StudioKAT/AnalogChaos/README.md

# Analog Chaos

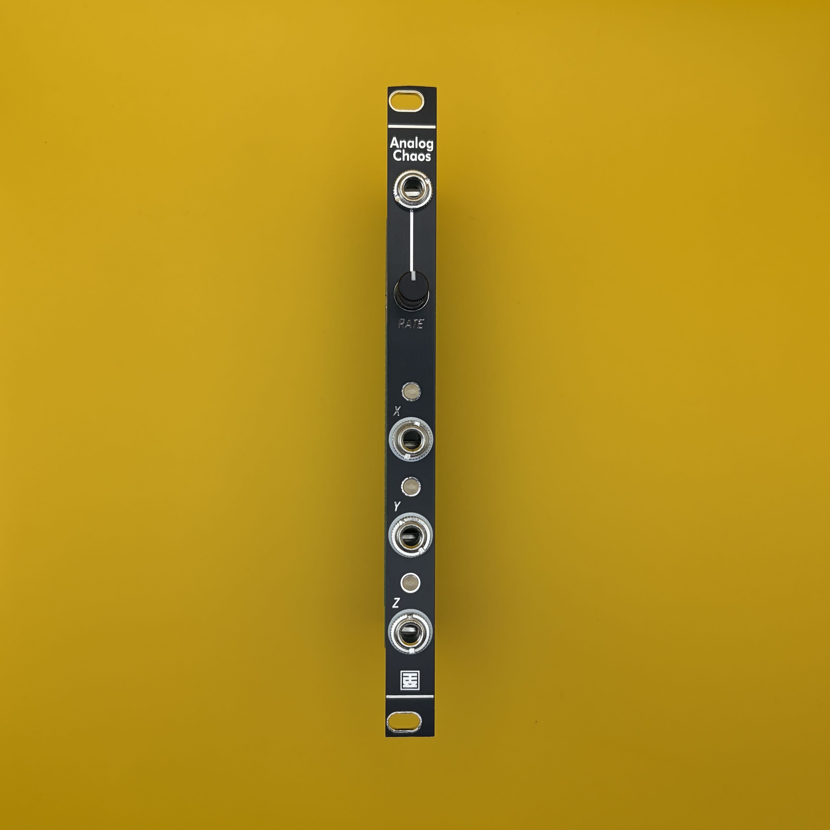
[picture p1: v2.0/Images/Analog Chaos_v2.0_Front.jpg]
Analog Chaos_v2.0_Front


## 概要 / Overview

**Analog Chaos**は、2HPサイズの電圧制御可能なJerk Chaos CVジェネレーターです。

アナログ回路のフィードバックが生み出す、決定論的でありながら不規則な変化が特徴です。パッチに「偶然のようで、どこか連続性のある」揺らぎを加えます。

相互に関連しながら異なる表情を見せるX・Y・Zの3つのCV出力を搭載。複数のパラメーターを同時に変調することで、つながりのある複雑な動きを作り出せます。

変化の速度はRateノブと外部CVで調整でき、超低速域からLFO領域まで対応します。ゆっくりと移り変わる音色から、不規則なうねりまで、幅広いモジュレーションに活用できます。

基板上には、動きの性質を調整する4つの半固定抵抗を備えています。  
- Damp：振動を抑える帰還の強さを調整します。動きの勢いや収まり方に関わります。
- Gain：信号を回路へ戻す帰還の利得を調整します。出力音量ではなく、カオスを生み出すループの働きに関わります。
- Mod：回路内部に加える直流バイアスを調整します。動作の中心をずらすことで、揺らぎの偏りや動き方を変化させます。
- NL Drive：ダイオードによる非線形帰還の強さを調整します。波形の折れ曲がり方や、不規則な動きの生じ方に関わります。

これらは互いに影響し合い、設定によって不規則な揺らぎから周期的な動き、変化が収まる状態まで、振る舞いが変化します。

---

**Analog Chaos** is a voltage-controlled jerk chaos CV generator in a compact 2HP Eurorack format.

Feedback within its analog circuitry produces behavior that is deterministic yet irregular, adding fluctuations to your patch that feel unpredictable while retaining a sense of continuity.

Three CV outputs—X, Y, and Z—provide distinct but interrelated signals. Modulate multiple parameters simultaneously to create complex, connected movement throughout your patch.

The Rate knob and external CV input control the speed of these changes, covering a range from ultra-slow movement to LFO rates. From gradually evolving timbres to irregular swells, Analog Chaos offers a wide range of modulation possibilities.

Four trimmers on the circuit board let you adjust the character of the movement:

- **Damp:** Adjusts the strength of the feedback that damps oscillation, influencing how vigorously the circuit moves and how its motion settles.
- **Gain:** Adjusts the gain of the feedback loop that generates chaos, shaping the circuit’s behavior rather than directly setting the output level.
- **Mod:** Adjusts an internal DC bias, shifting the circuit’s operating point to change the balance and character of its fluctuations.
- **NL Drive:** Adjusts the strength of the nonlinear feedback through the diodes, influencing how the waveform bends and how irregular movement develops.

These controls interact with one another. Depending on their settings, the circuit can move between chaotic fluctuations, periodic oscillation, and a settled state.

## 仕様 / Spec
- Format: Eurorack
- Function: Chaos
- Current needs: +12V: 25mA, -12V: 25mA
- Width: 2 HP
- Depth: 36mm (including power connector)

## 販売 / Sales

StudioKATオフィシャルショップで販売しています。(日本国内限定)  
https://www.studiokat.jp/items/164466150

## ライセンス / License

この作品は [Creative Commons 表示 - 継承 4.0 国際 (CC BY-SA 4.0)](https://creativecommons.org/licenses/by-sa/4.0/deed.ja) の下でライセンスされています。  
This work is licensed under the [Creative Commons Attribution-ShareAlike 4.0 International License](https://creativecommons.org/licenses/by-sa/4.0/).

## クレジット / Credits

- Designed by : StudioKAT
- Website : https://www.studiokat.jp/
- GitHub : https://github.com/StudioKAT
- X(Twitter) : https://x.com/StudioKAT_synth
- Instagram : https://www.instagram.com/studiokat_modular/

## 更新履歴 / Changelog

- `2026-10-30` v2.0 Released version 2.0
- `2026-07-05` v1.0 Released version 1.0
