StudioKAT/AnalogChaos/v2.0/Images/Analog Chaos_v2.0_Side2.jpg

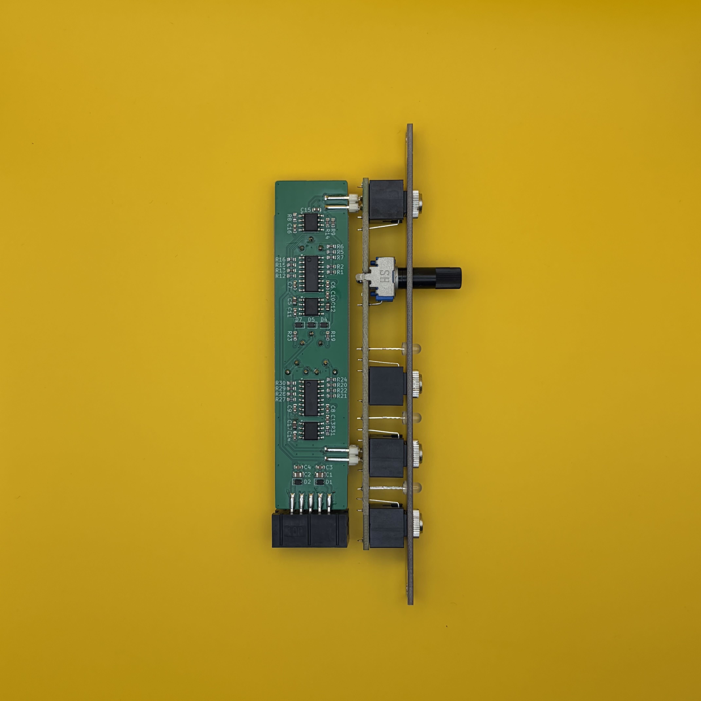
v2.0/Images/Analog Chaos_v2.0_Side2.jpg
