StudioKAT/AnalogChaos/v2.0/Gerber_for_JLCPCB/Main/bom.csv

Designator | Footprint | Quantity | Value | LCSC Part #
C1, C2 | 0805 | 2 | 22uF | C45783
C10, C11, C13, C14, C15, C16, C3, C4, C6, C7, C8, C9 | 0603 | 12 | 100nF | C14663
C12, C17, C5 | 0603 | 3 | 10uF | C96446
D1, D2 | D_SOD-323 | 2 | 1N5819WS | C191023
D3 | LED_D3.0mm_Clear | 1 | LED_Z
D4, D5, D7 | D_SOD-323 | 3 | 1N4148WS | C2128
D6 | LED_D3.0mm_Clear | 1 | LED_Y
D8 | LED_D3.0mm_Clear | 1 | LED_X
J1 | IDC-Header_2x05_P2.54mm_Horizontal_SMD_EuroPower | 1 | Power
J2 | Jack_3.5mm_QingPu_WQP-PJ398SM | 1 | Rate_CV
J3 | Jack_3.5mm_QingPu_WQP-PJ398SM | 1 | OUT_Z
J4 | Jack_3.5mm_QingPu_WQP-PJ398SM | 1 | OUT_Y
J5, J8 | PinHeader_2x02_P2.54mm_Stand_SMD | 2 | Conn_02x02_Odd_Even
J6, J9 | PinHeader_2x02_P2.54mm_Vertical_SMD | 2 | Conn_02x02_Odd_Even
J7 | Jack_3.5mm_QingPu_WQP-PJ398SM | 1 | OUT_X
R1, R13, R15, R2, R21, R22, R28, R29 | 0603 | 8 | 220 | C22962
R10, R17, R25 | 0603 | 3 | 2.2k | C4190
R11, R18, R23, R26 | 0603 | 4 | 1k | C21190
R12, R14, R19, R27, R4, R5, R8, R9 | 0603 | 8 | 100k | C25803
R16, R24, R30, R7 | 0603 | 4 | 22k | C31850
R20 | 0603 | 1 | 220k | C22961
R3 | 0603 | 1 | 120k | C25808
R31 | 0603 | 1 | 180k | C22827
R6 | 0603 | 1 | 56k | C23206
RV1 | Potentiometer_RV09 | 1 | B100K
RV2, RV3, RV5 | Potentiometer_Vishay_T73YP_Vertical | 3 | 100K
RV4 | Potentiometer_Vishay_T73YP_Vertical | 1 | 10K
U1, U4 | SOIC-16_3.9x9.9mm_P1.27mm | 2 | LM13700MX/NOPB | C174050
U2, U3, U5 | SOIC-8_3.9x4.9mm_P1.27mm | 3 | TL072CDT | C6961
