StudioKAT/AnalogChaos/v2.0/Schematics/Analog Chaos v2.0_schematics.pdf

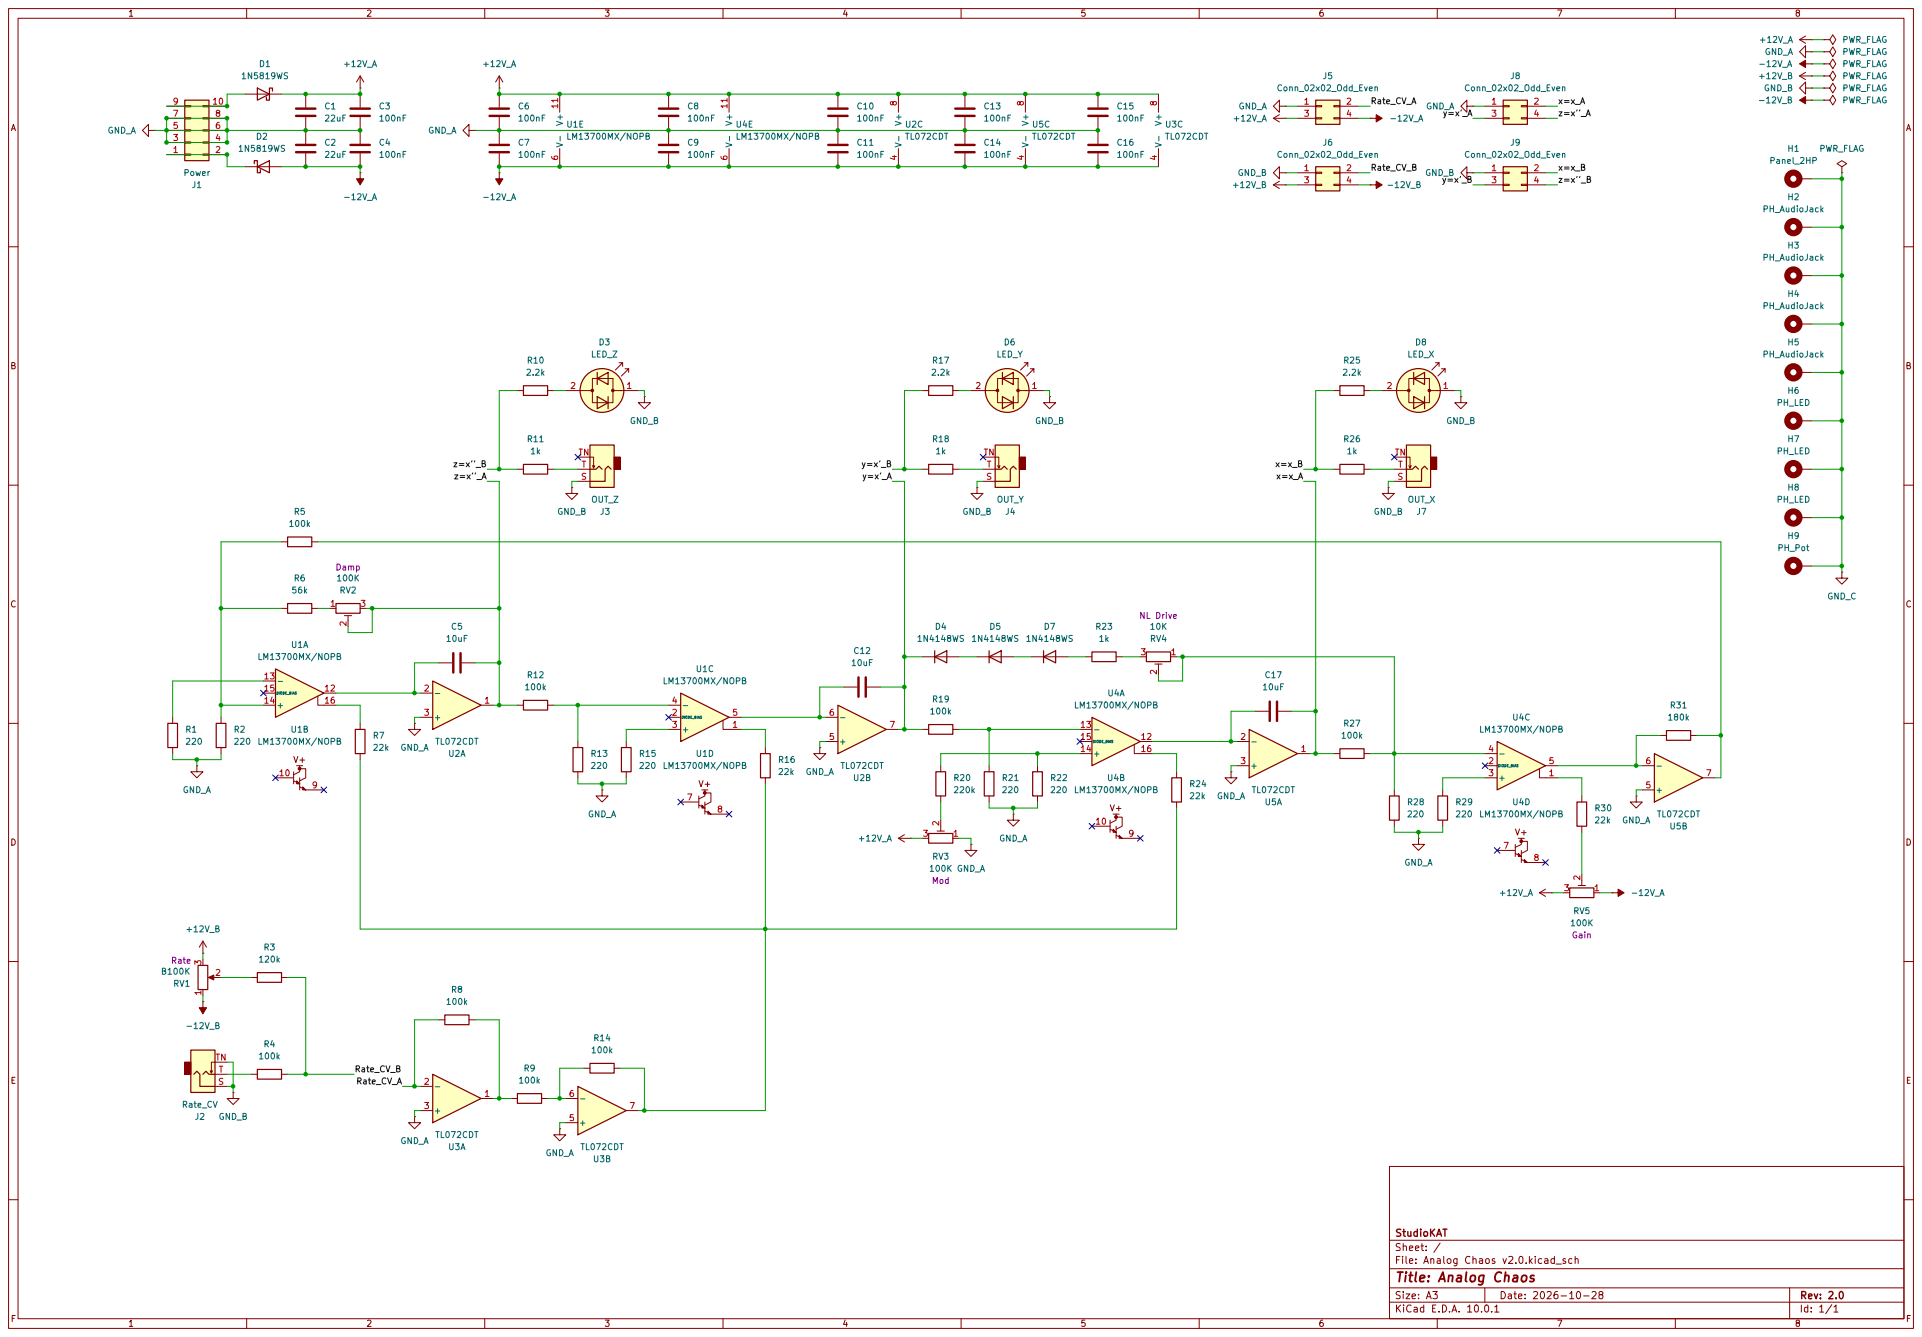
[picture p4: page 1]
