StudioKAT/AnalogChaos/v2.0/KiCAD/Analog Chaos v2.0/Analog Chaos v2.0.kicad_pcb

## KiCad design v2.0/KiCAD/Analog Chaos v2.0/Analog Chaos v2.0.kicad_pcb (2026-10-30)

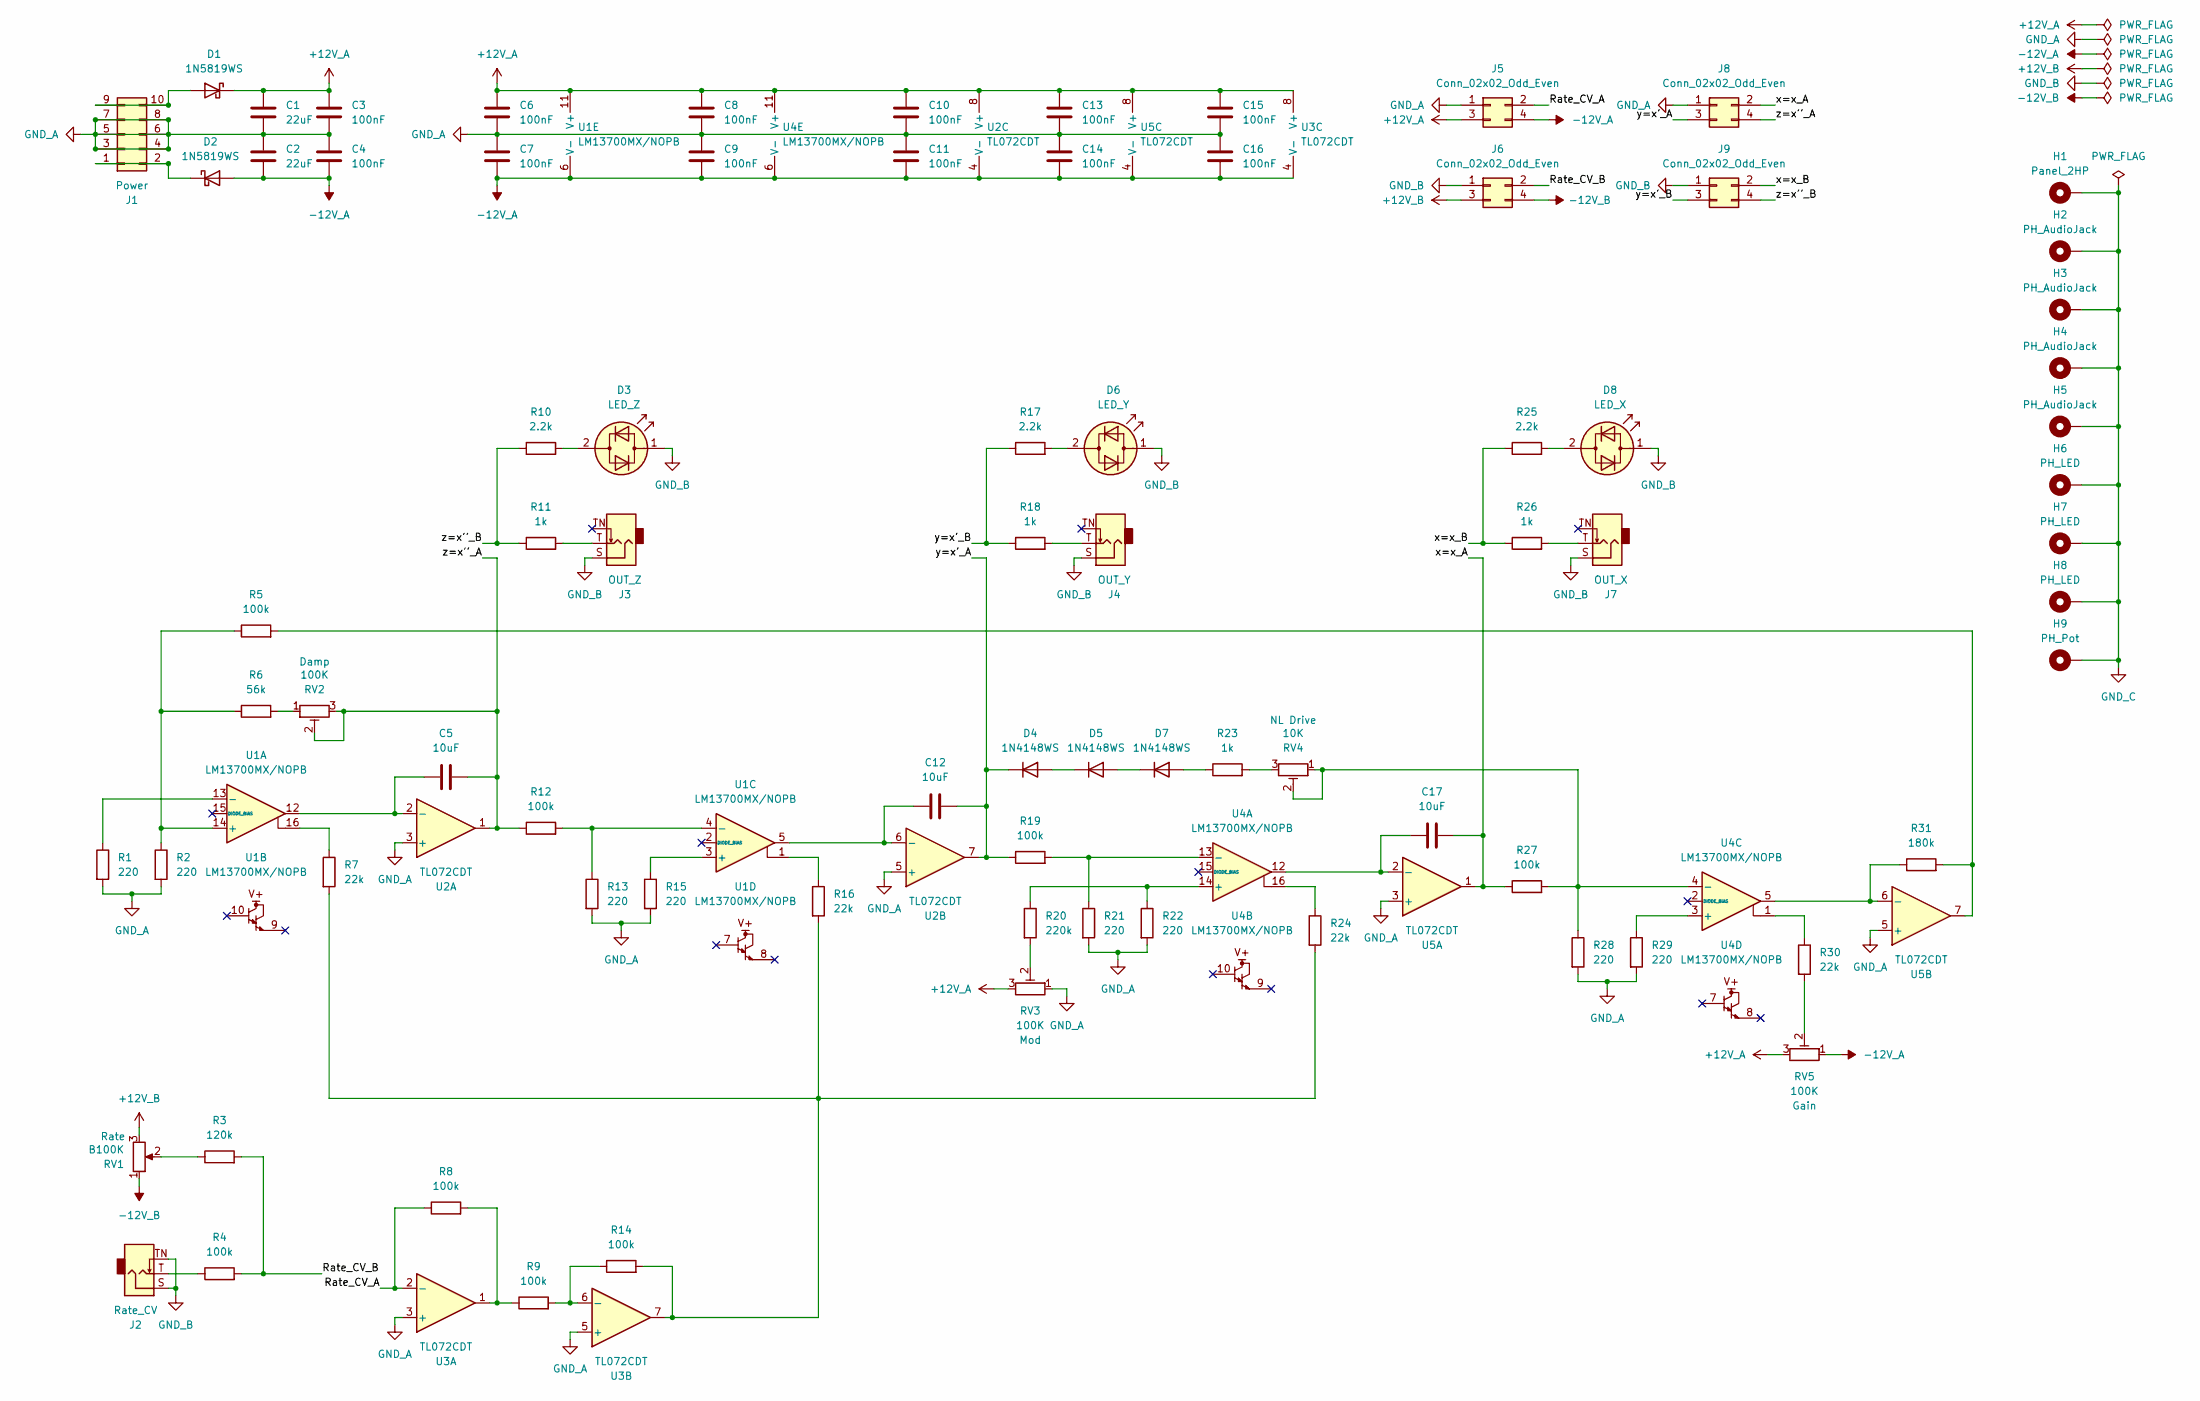
[picture p5: schematic Analog Chaos v2.0.kicad_sch, Analog Chaos]

Parts:
C1, C2: 22uF; C_0805_2012Metric; Voltage 25V; Tolerance ±20%; MFR Part CL21A226MAQNNNE; JLC Type Basic
C3, C4, C6, C7, C8, C9, C10, C11, C13, C14, C15, C16: 100nF; C_0603_1608Metric; Voltage 50V; Tolerance ±10%; MFR Part CC0603KRX7R9BB104; JLC Type Basic
C5, C12, C17: 10uF; C_0603_1608Metric; Voltage 25V; Tolerance ±20%; MFR Part CL10A106MA8NRNC; JLC Type Basic
D1, D2: 1N5819WS; D_SOD-323; MFR Part 1N5819WS; JLC Type Basic
D3: LED_Z; LED_D3.0mm_Clear
D4, D5, D7: 1N4148WS; D_SOD-323; MFR Part 1N4148WS; JLC Type Basic
D6: LED_Y; LED_D3.0mm_Clear
D8: LED_X; LED_D3.0mm_Clear
H1: Panel_2HP
H2, H3, H4, H5: PH_AudioJack; PH_AudioJack_3.5mm_Pad
H6, H7, H8: PH_LED; PH_LED_3.0mm_Pad
H9: PH_Pot; PH_RV09
J1: Power; IDC-Header_2x05_P2.54mm_Horizontal_SMD_EuroPower
J2: Rate_CV; Jack_3.5mm_QingPu_WQP-PJ398SM
J3: OUT_Z; Jack_3.5mm_QingPu_WQP-PJ398SM
J4: OUT_Y; Jack_3.5mm_QingPu_WQP-PJ398SM
J5, J8: Conn_02x02_Odd_Even; PinHeader_2x02_P2.54mm_Stand_SMD
J6, J9: Conn_02x02_Odd_Even; PinHeader_2x02_P2.54mm_Vertical_SMD
J7: OUT_X; Jack_3.5mm_QingPu_WQP-PJ398SM
R1, R2, R13, R15, R21, R22, R28, R29: 220; R_0603_1608Metric; Tolerance ±1%; MFR Part 0603WAF2200T5E; JLC Type Basic
R3: 120k; R_0603_1608Metric; Tolerance ±1%; MFR Part 0603WAF1203T5E; JLC Type Basic
R4, R5, R8, R9, R12, R14, R19, R27: 100k; R_0603_1608Metric; Tolerance ±1%; MFR Part 0603WAF1003T5E; JLC Type Basic
R6: 56k; R_0603_1608Metric; Tolerance ±1%; MFR Part 0603WAF5602T5E; JLC Type Basic
R7, R16, R24, R30: 22k; R_0603_1608Metric; Tolerance ±1%; MFR Part 0603WAF2202T5E; JLC Type Basic
R10, R17, R25: 2.2k; R_0603_1608Metric; Tolerance ±1%; MFR Part 0603WAF2201T5E; JLC Type Basic
R11, R18, R23, R26: 1k; R_0603_1608Metric; Tolerance ±1%; MFR Part 0603WAF1001T5E; JLC Type Basic
R20: 220k; R_0603_1608Metric; Tolerance ±1%; MFR Part 0603WAF2203T5E; JLC Type Basic
R31: 180k; R_0603_1608Metric; Tolerance ±1%; MFR Part 0603WAF1803T5E; LCSC C22827
RV1: B100K; Potentiometer_RV09
RV2, RV3, RV5: 100K; Potentiometer_Vishay_T73YP_Vertical
RV4: 10K; Potentiometer_Vishay_T73YP_Vertical
U1, U4: LM13700MX/NOPB; SOIC-16_3.9x9.9mm_P1.27mm; LCSC C174050
U2, U3, U5: TL072CDT; SOIC-8_3.9x4.9mm_P1.27mm; MFR Part TL072CDT; JLC Type Basic

Connections:
+12V_A: C1.1, C3.1, C6.1, C8.1, C10.1, C13.1, C15.1, D1.1 (K), J5.3, RV3.3, RV5.3, U1.11 (V+), U2.8 (V+), U3.8 (V+), U4.11 (V+), U5.8 (V+)
+12V_B: J6.3, RV1.3
-12V_A: C2.2, C4.2, C7.2, C9.2, C11.2, C14.2, C16.2, D2.2 (A), J5.4, RV5.1, U1.6 (V-), U2.4 (V-), U3.4 (V-), U4.6 (V-), U5.4 (V-)
-12V_B: J6.4, RV1.1
/Rate_CV_A: J5.2, R8.1, U3.2 (-)
/Rate_CV_B: J6.2, R3.2, R4.2
/x=x_A: C17.2, J8.2, R27.1, U5.1
/x=x_B: J9.2, R25.1, R26.1
/y=x'_A: C12.2, D4.1 (K), J8.3, R19.1, U2.7
/y=x'_B: J9.3, R17.1, R18.1
/z=x''_A: C5.2, J8.4, R12.1, RV2.2, RV2.3, U2.1
/z=x''_B: J9.4, R10.1, R11.1
GND_A: C1.2, C2.1, C3.2, C4.1, C6.2, C7.1, C8.2, C9.1, C10.2, C11.1, C13.2, C14.1, C15.2, C16.1, J1.3, J1.4, J1.5, J1.6, J1.7, J1.8, J5.1, J8.1, R1.2, R2.2, R13.2, R15.2, R21.2, R22.2, R28.2, R29.2, RV3.1, U2.3 (+), U2.5 (+), U3.3 (+), U3.5 (+), U5.3 (+), U5.5 (+)
GND_B: D3.1 (KA), D6.1 (KA), D8.1 (KA), J2.S, J2.TN, J3.S, J4.S, J6.1, J7.S, J9.1
GND_C: H1.1 (1_1), H2.1 (1_1), H3.1 (1_1), H4.1 (1_1), H5.1 (1_1), H6.1 (1_1), H7.1 (1_1), H8.1 (1_1), H9.1 (1_1)
unnamed: D1.2 (A), J1.9, J1.10
unnamed: D2.1 (K), J1.1, J1.2
unnamed: D3.2 (AK), R10.2
unnamed: D4.2 (A), D5.1 (K)
unnamed: D5.2 (A), D7.1 (K)
unnamed: D6.2 (AK), R17.2
unnamed: D7.2 (A), R23.1
unnamed: D8.2 (AK), R25.2
unnamed: J2.T, R4.1
unnamed: J3.T, R11.2
unnamed: J4.T, R18.2
unnamed: J7.T, R26.2
unnamed: R3.1, RV1.2
unnamed: R6.2, RV2.1
unnamed: R7.1, U1.16
unnamed: R8.2, R9.1, U3.1
unnamed: R7.2, R14.2, R16.2, R24.2, U3.7
unnamed: R16.1, U1.1
unnamed: R20.2, RV3.2
unnamed: R23.2, RV4.3
unnamed: R24.1, U4.16
unnamed: R30.1, U4.1
unnamed: R30.2, RV5.2
unnamed: R5.2, R31.2, U5.7
unnamed: R2.1, R5.1, R6.1, U1.14 (+)
unnamed: R1.1, U1.13 (-)
unnamed: R15.1, U1.3 (+)
unnamed: R12.2, R13.1, U1.4 (-)
unnamed: C5.1, U1.12, U2.2 (-)
unnamed: C12.1, U1.5, U2.6 (-)
unnamed: R9.2, R14.1, U3.6 (-)
unnamed: R20.1, R22.1, U4.14 (+)
unnamed: R19.2, R21.1, U4.13 (-)
unnamed: R29.1, U4.3 (+)
unnamed: R27.2, R28.1, RV4.1, RV4.2, U4.4 (-)
unnamed: C17.1, U4.12, U5.2 (-)
unnamed: R31.1, U4.5, U5.6 (-)

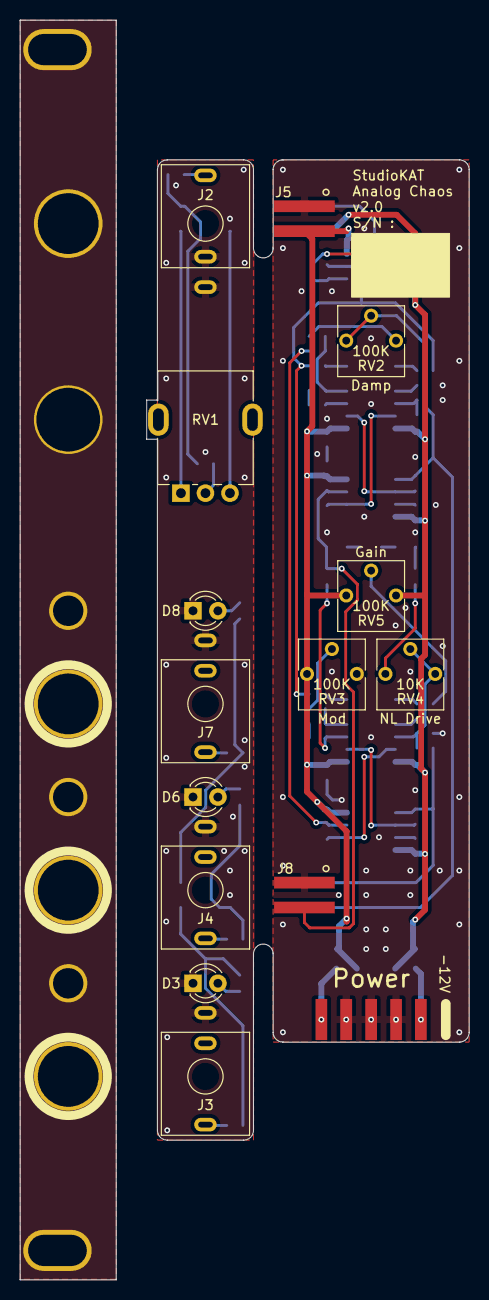
[picture p6: board Analog Chaos v2.0.kicad_pcb from above]

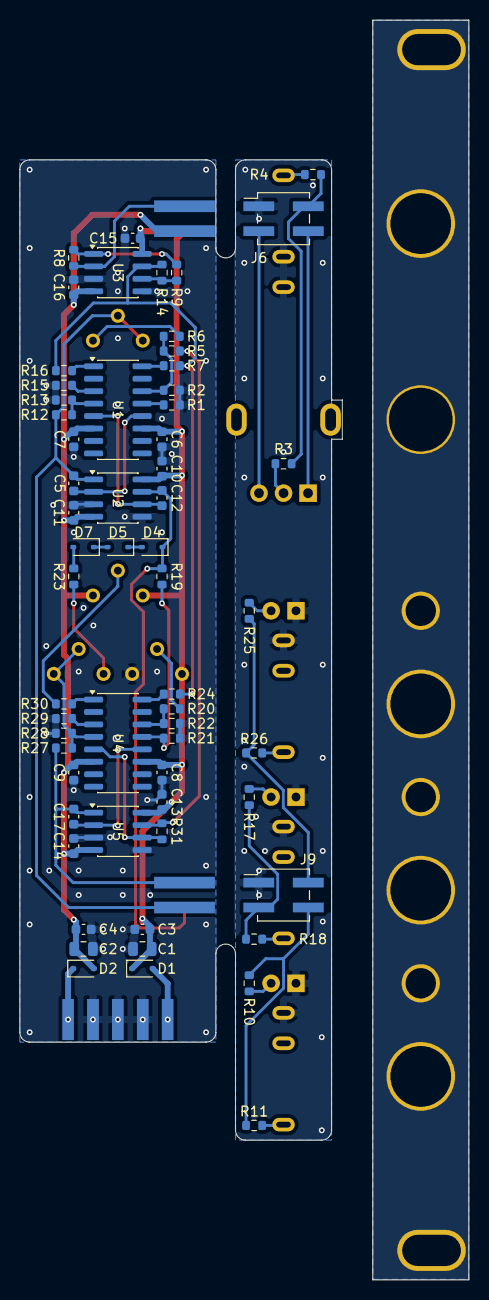
[picture p7: board Analog Chaos v2.0.kicad_pcb from below]

Board: 2 copper layers, 32.9 x 100.0 mm, 84 parts (60 on the bottom side), 52 nets.
