StudioKAT/AnalogChaos/(commit log)

2026-07-06 オシロスコープ追加
2026-10-30 v2.0リリース
    [Analog Chaos v2.0.kicad_pcb, Analog Chaos v2.0.kicad_sch, bom.csv, positions.csv]
2026-10-30 Stop tracking ignored KiCad backup files
    [Analog Chaos.kicad_pcb, Analog Chaos.kicad_sch, bom.csv, positions.csv]
